sg6336/Clock_STM8/README.md

# Clock_STM8
Схема годинника зроблена в Altium. На перевірку

https://youtube.com/shorts/jYWQ8iIIEtU
