sg6336/Clock_STM8/Embedded STM8S103F3/STM8_Clock_Ajax/README.md

```
project-root/
│
├── config/
│
├── core/                       # Бізнес-логіка (платформонезалежна)
│   ├── logic/                  # Логіка годинника, зміни часу, інтерфейс користувача
│   └── interfaces/             # Інтерфейси, які реалізують драйвери
│
├── drivers/                    # Драйвери для периферії
│   ├── inc/                    # Відповідні заголовки для src/
│   │   ├── buttons/
│   │   ├── ds3231/
│   │   ├── tm1637/
│   │   └── uart/
│   │
│   └── src/                    # Платформозалежна реалізація (STM8, реєстри тощо)
│       ├── buttons/
│       ├── ds3231/
│       ├── tm1637/
│       └── uart/
│
├── platform/                   # Платформа і toolchain-специфічні файли
│   └── cosmic_stm8/
│       └── include/
│       │   └── iostm8s103.h    # Реєстри, визначені компілятором Cosmic
│       ├── scr/
│       └── inc/
│
├── startup/                    # Стартові файли (main.c, stm8_interrupt_vector.c)
│
├── tests/                      # Юніт-тести
│
├── build/                      # Збірка
│
├── tools/                      # Скріпти: .bat, генерація .lkf, прошивка
│
├── .vscode/                    # Налаштування для VS Code
│
└── README.md
```
Структура взаємодії:
```
[core/] (бізнес логіка)
     ⬇
[interfaces/] (контракт)
     ⬇
[drivers/] (реалізація інтерфейсу)
     ⬇
[hal/] (виклики до регістрів)
     ⬇
[iostm8s103.h] (реєстри STM8)
```
