sg6336/Clock_STM8/Docs/PCB_Clock_STM8.vProject_Version/Gerber_PCB_Clock_STM8.vProject_Version_(2025-02-28)/PCB_Requirements_PCB_Clock_STM8.v1.0.0.xlsx

PCB Name | PCB_Clock_STM8.v1.0 | Template version 1.0.3 | <Parameter PCB_Version not found>
Author | Denys
Amount boards per stand | 1
Produced within | 2 weeks
Item | Requirement | Comment
Layer count | 2
Size | 80 x 80 mm
Thickness | 1.6 mm
Material | FR-4
Min track/spacing | 0.254mm / 10mil
Min hole size | 0.6 mm
Copper weight | 1oz / 35um
Mask | on both sides
Mask color | Green / Yellow
Castellated holes edges | No
Surfaces finishing | HASL
Silkscreen | YES
Silkscreen color | White
Board Outline, Cutout | Mechanical1 (GM1)
Electric test | Necessarily for 100% samples
