sg6336/Clock_STM8/Embedded STM8S103F3/README.md

# Clock_STM8
Схема годинника зроблена в Altium. На перевірку

Clock_photo_rev.1
