sg6336/Clock_STM8/Docs/PCB_Clock_STM8.vProject_Version/Bill of Materials - PCB_Clock_STM8.vProject_Version.xlsx

Designator | Comment | Description | Footprint | LibRef | Quantity | Brand | Description(type) | Part Number | Replacement | Temperature of soldering | Tolerance | Country | Package | Datasheet
BT1 | CR2032 | Cell Holder for CR2032 | PCB_Battery | Battery | 1
C1 | 10uF | Cap Ceramic 10uF 25V B 10% Pad SMD 1206 85Â°C T/R | CAPC3216X190 | GRM31CB31E106KA75L | 1 |  |  |  |  |  |  |  | None
C2 | 22uF | CAPACITOR, 1206, X5R, 25V, 22UF; Dielectric Characteristic:X5R; Capacitance:22µF; Capacitance Tolerance:± 10%; Voltage Rating:25V; Series:GRM Hi-Cap; Capacitor Case Style:1206; No. of Pins:2; Capacitor Mounting:SMD; SVHC:No SVHC ;RoHS Compliant: Yes | CAPC3216X125N | GRM31CR61E226KE15L | 1 |  |  |  |  |  |  |  | None
C3, C4, C8, C12, C13 | 100nF | Ceramic capacitor SMD 1206 100 nF 50 V 10 % Samsung Electro-Mechanics CL31B104KBCNNNC 4000 pc(s) | CAPC3216X180N | CL31B104KBCNNNC | 5 |  |  |  |  |  |  |  | 1206 Samsung
C5, C9 | 1uF | CAP CER 1UF 25V X7R 1206 | CAPC3216X110N | C1206C105J3RACTU | 2 |  |  |  |  |  |  |  | None
C6, C7 | 100pF | CAP, MLCC, C0G, 100PF, 630V, 1206 | CAPC3216X110N | C1206C101JBGACTU | 2 |  |  |  |  |  |  |  | None
C10 | 100uF | 100µF Â±10% 6.3V Ceramic Capacitor X5R 1206 _3216 Metric_ | CAP3216X125N | GRM31CR60J107KE39L | 1 |  |  |  |  |  |  |  | 1206 Murata
C11 | 680nF | .68UF 50V 10% 1206 | CAPC3216X110N | C1206C684K5RACTU | 1 |  |  |  |  |  |  |  | None
D1 | 1N5819 | Diode Schottky 40 V 1A Surface Mount SOD-123 | SOD3715X145N | 1N5819HW-7 | 1 |  |  |  |  |  |  |  | SOD-123 Fairchild Semiconductor
D2 | LED | 2.6 V Red LED SMD | LEDC3216X120N | LHN974_RED_LED_1206 | 1 |  |  |  |  |  |  |  | None
D3 | LCD | Display, Seven Segment, 9.2MM, Red | LED_LDQ-M3604RI | LDQ-M3604RI | 1 |  |  |  |  |  |  |  | None
J1 | USB |  | GCT_USB4105-GF-A | USB4105-GF-A | 1 |  |  |  |  |  |  |  | None
R1, R2, R3, R4, R5, R6, R10, R11 | 10k | RES, 10K, 1%, 0.25W, 1206, THICK FILM; Resistor Case Style:1206 [3216 Metric]; Resistance:10kohm; Product Range:RC Series; Voltage Rating:200V; Resistor Element Material:Thick Film; Power Rating:250mW; Resistance Tolerance:Â± 1%; Temperature Coefficient:Â± 100ppm/Â°C; Automotive Qualification Standard:-; SVHC:No SVHC (15-Jan-2019) | RESC3216X71N | RC1206FR-0710KL | 8 |  |  |  |  |  |  |  | 1206-2 YAGEO
R7, R8, R9 | 1k | Surge Chip Resistor Automotive Grade Thick Film 1206 1kOhm 1% Paper T/R | RESC3116X65N | SR1206FR-071KL | 3 |  |  |  |  |  |  |  | 1206-2 YAGEO
SW1, SW2 | BUTTON | Alcoswitch, Switch, Tactile, 50 mA, SPST, Pushbutton, Off[On], FSM6JSMA | TE Connectivity FSM6JSMA | TE_4-1437565-9 | 4-1437565-9 | 2 |  |  |  |  |  |  |  | None
U1 | AMS1117-3.3 | LDO Voltage Regulators 1A, 3.3V | FP-AMS1117-IPC_A | CMP-209535-000001-1 | 1 |  |  |  |  |  |  |  | AMS1117
U2 | DS3231 | Extremely Accurate I2C-Integrated Real-Time Clock/TCXO/Crystal, 16-Pin SO, -40 to 85 degC, RoHS Qualified | W16#H2_N | CMP-0254-00293-2 | 1
U3 | TM1637 | LED Drive Control Special Circuit | SOIC127P1035X255-20N | TM1637_SOP20 | 1 |  |  |  |  |  |  |  | Package
U4 | STM8S103F3P6 | STM8 series Microcontroller IC 8-Bit 16MHz 8KB (8K x 8) FLASH 20-TSSOP | SOP65P640X120-20N | STM8S103F3P6 | 1 |  |  |  |  |  |  |  | TSSOP-20 STMicroelectronics
