sg6336/Clock_STM8/Altium/PCB_Clock_STM8/Docs/PCB_Clock_STM8_Fabrication.pdf

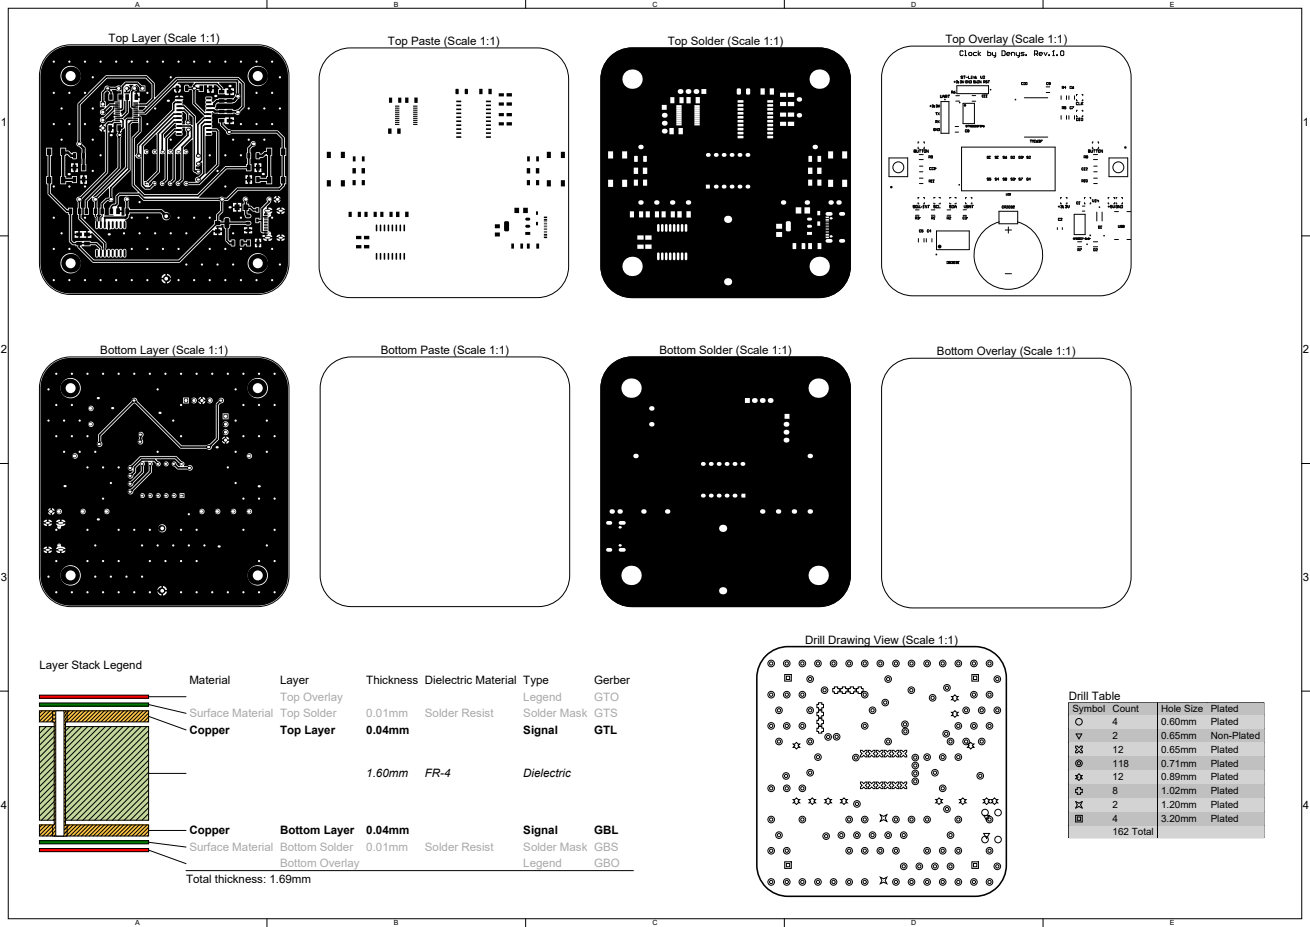
[picture p2: page 1]
Top Paste (Scale 1:1); Top Solder (Scale 1:1); Bottom Paste (Scale 1:1); Bottom Solder (Scale 1:1); Material; Layer; Thickness Dielectric Material Type; Gerber; Top Overlay; Legend; GTO; Surface Material Top Solder; Solder Resist; Solder Mask GTS; Copper; Top Layer; Signal; GTL; Dielectric; Bottom Layer 0.04mm; GBL; Surface Material Bottom Solder 0.01mm; Solder Mask GBS; Bottom Overlay; GBO; Total thickness: 1.69mm; Drill Table

Top Layer (Scale 1:1)

Top Overlay (Scale 1:1)

Bottom Layer (Scale 1:1)

Bottom Overlay (Scale 1:1)

Drill Drawing View (Scale 1:1)

Layer Stack Legend

Symbol | Count | Hole Size | Plated

4 | 0.60mm | Plated
2 | 0.65mm | Non-Plated
12 | 0.65mm | Plated
118 | 0.71mm | Plated
12 | 0.89mm | Plated
8 | 1.02mm | Plated
2 | 1.20mm | Plated
4 | 3.20mm | Plated
162 Total
