sg6336/Clock_STM8/Docs/PCB_Clock_STM8.vProject_Version/Internal_PCB_Clock_STM8.vProject_Version.PDF

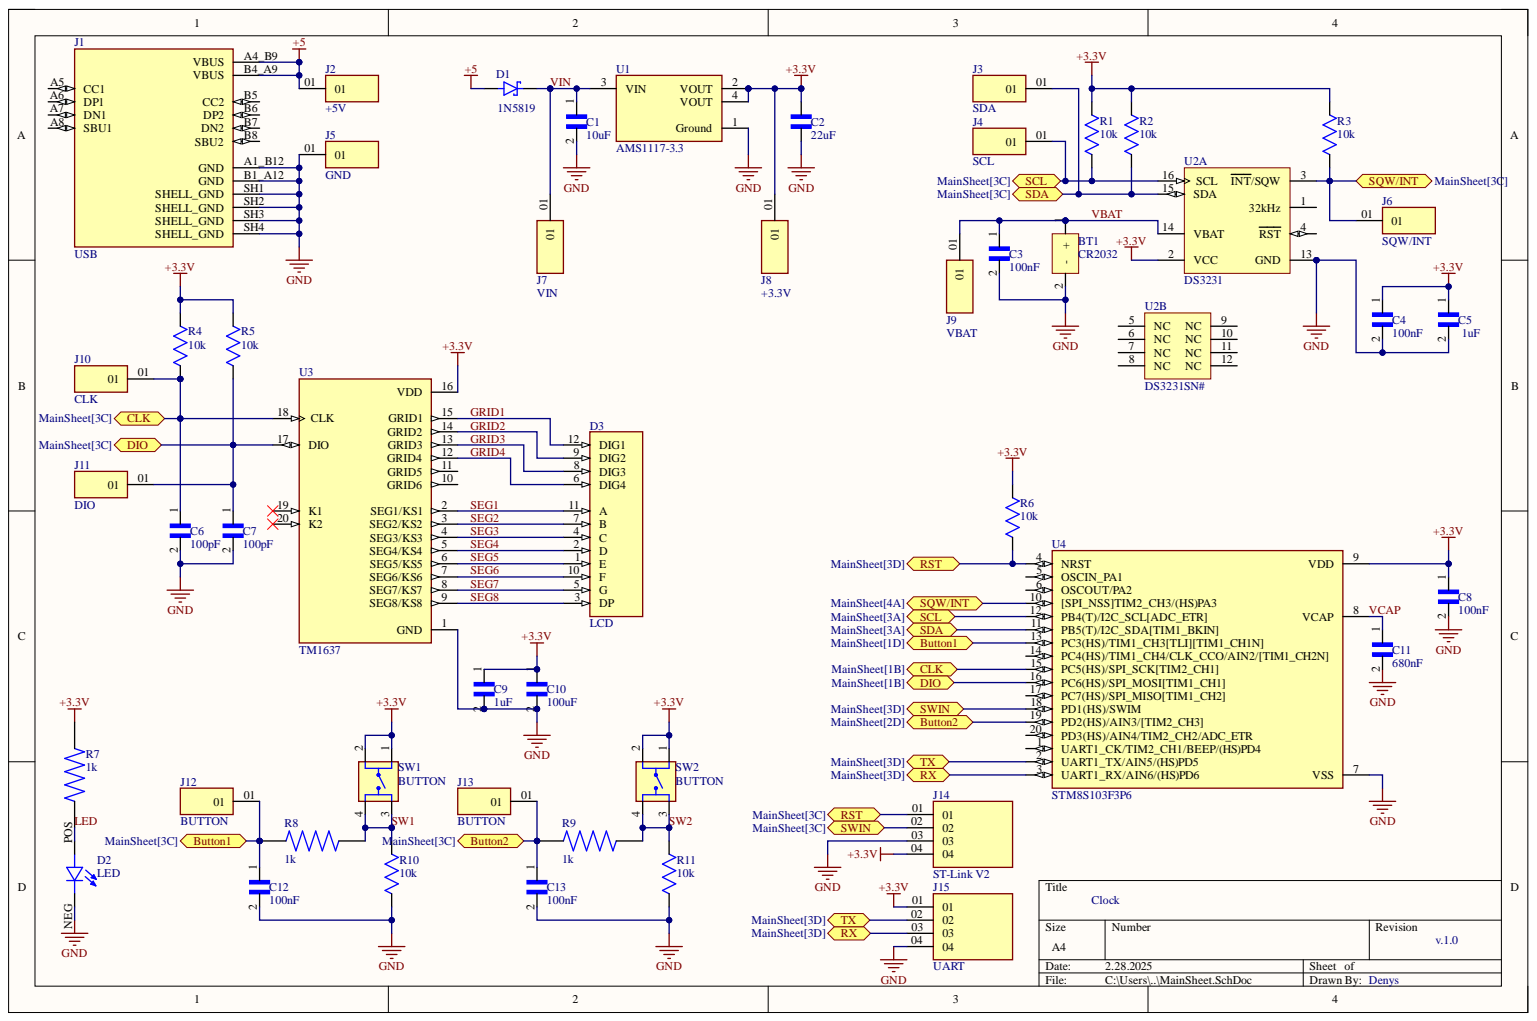
[picture p3: page 1]

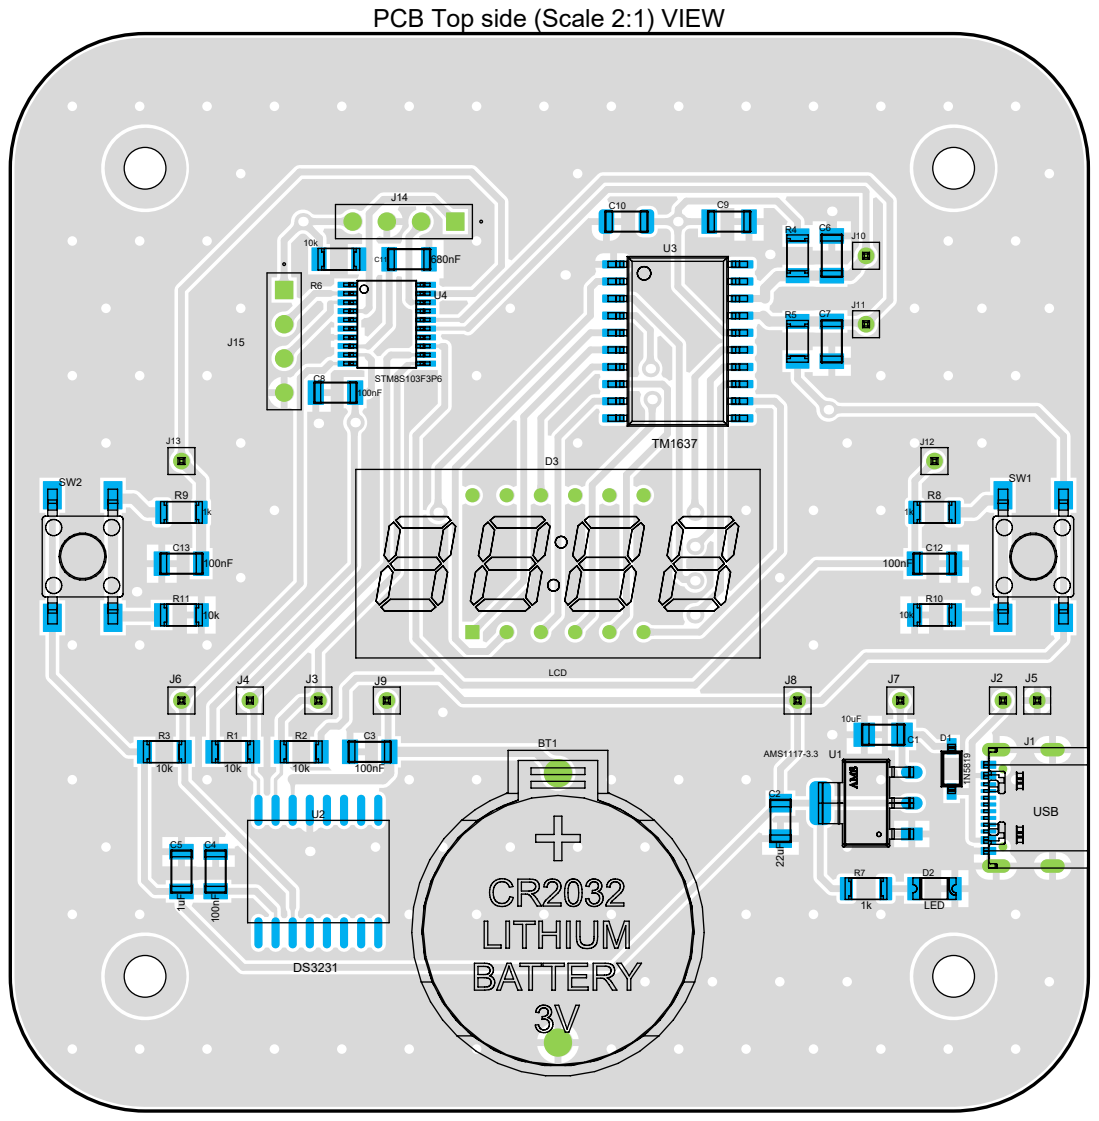
[picture p4: page 2]

PCB Top side (Scale 2:1) VIEW

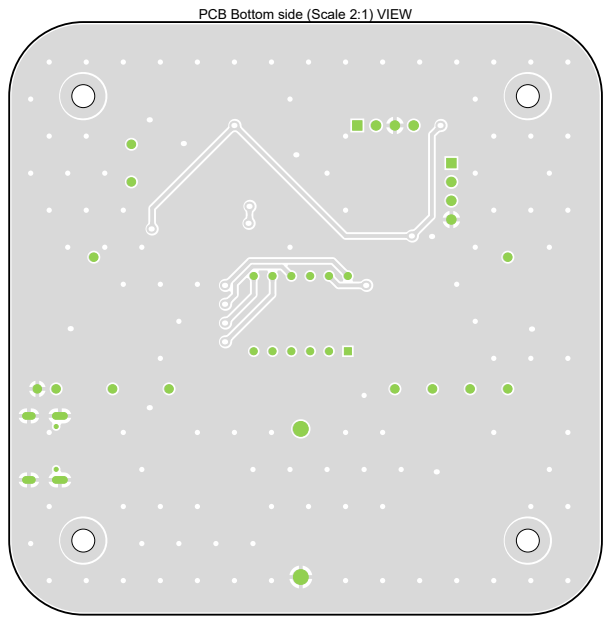
[picture p5: page 3]

PCB Bottom side (Scale 2:1) VIEW

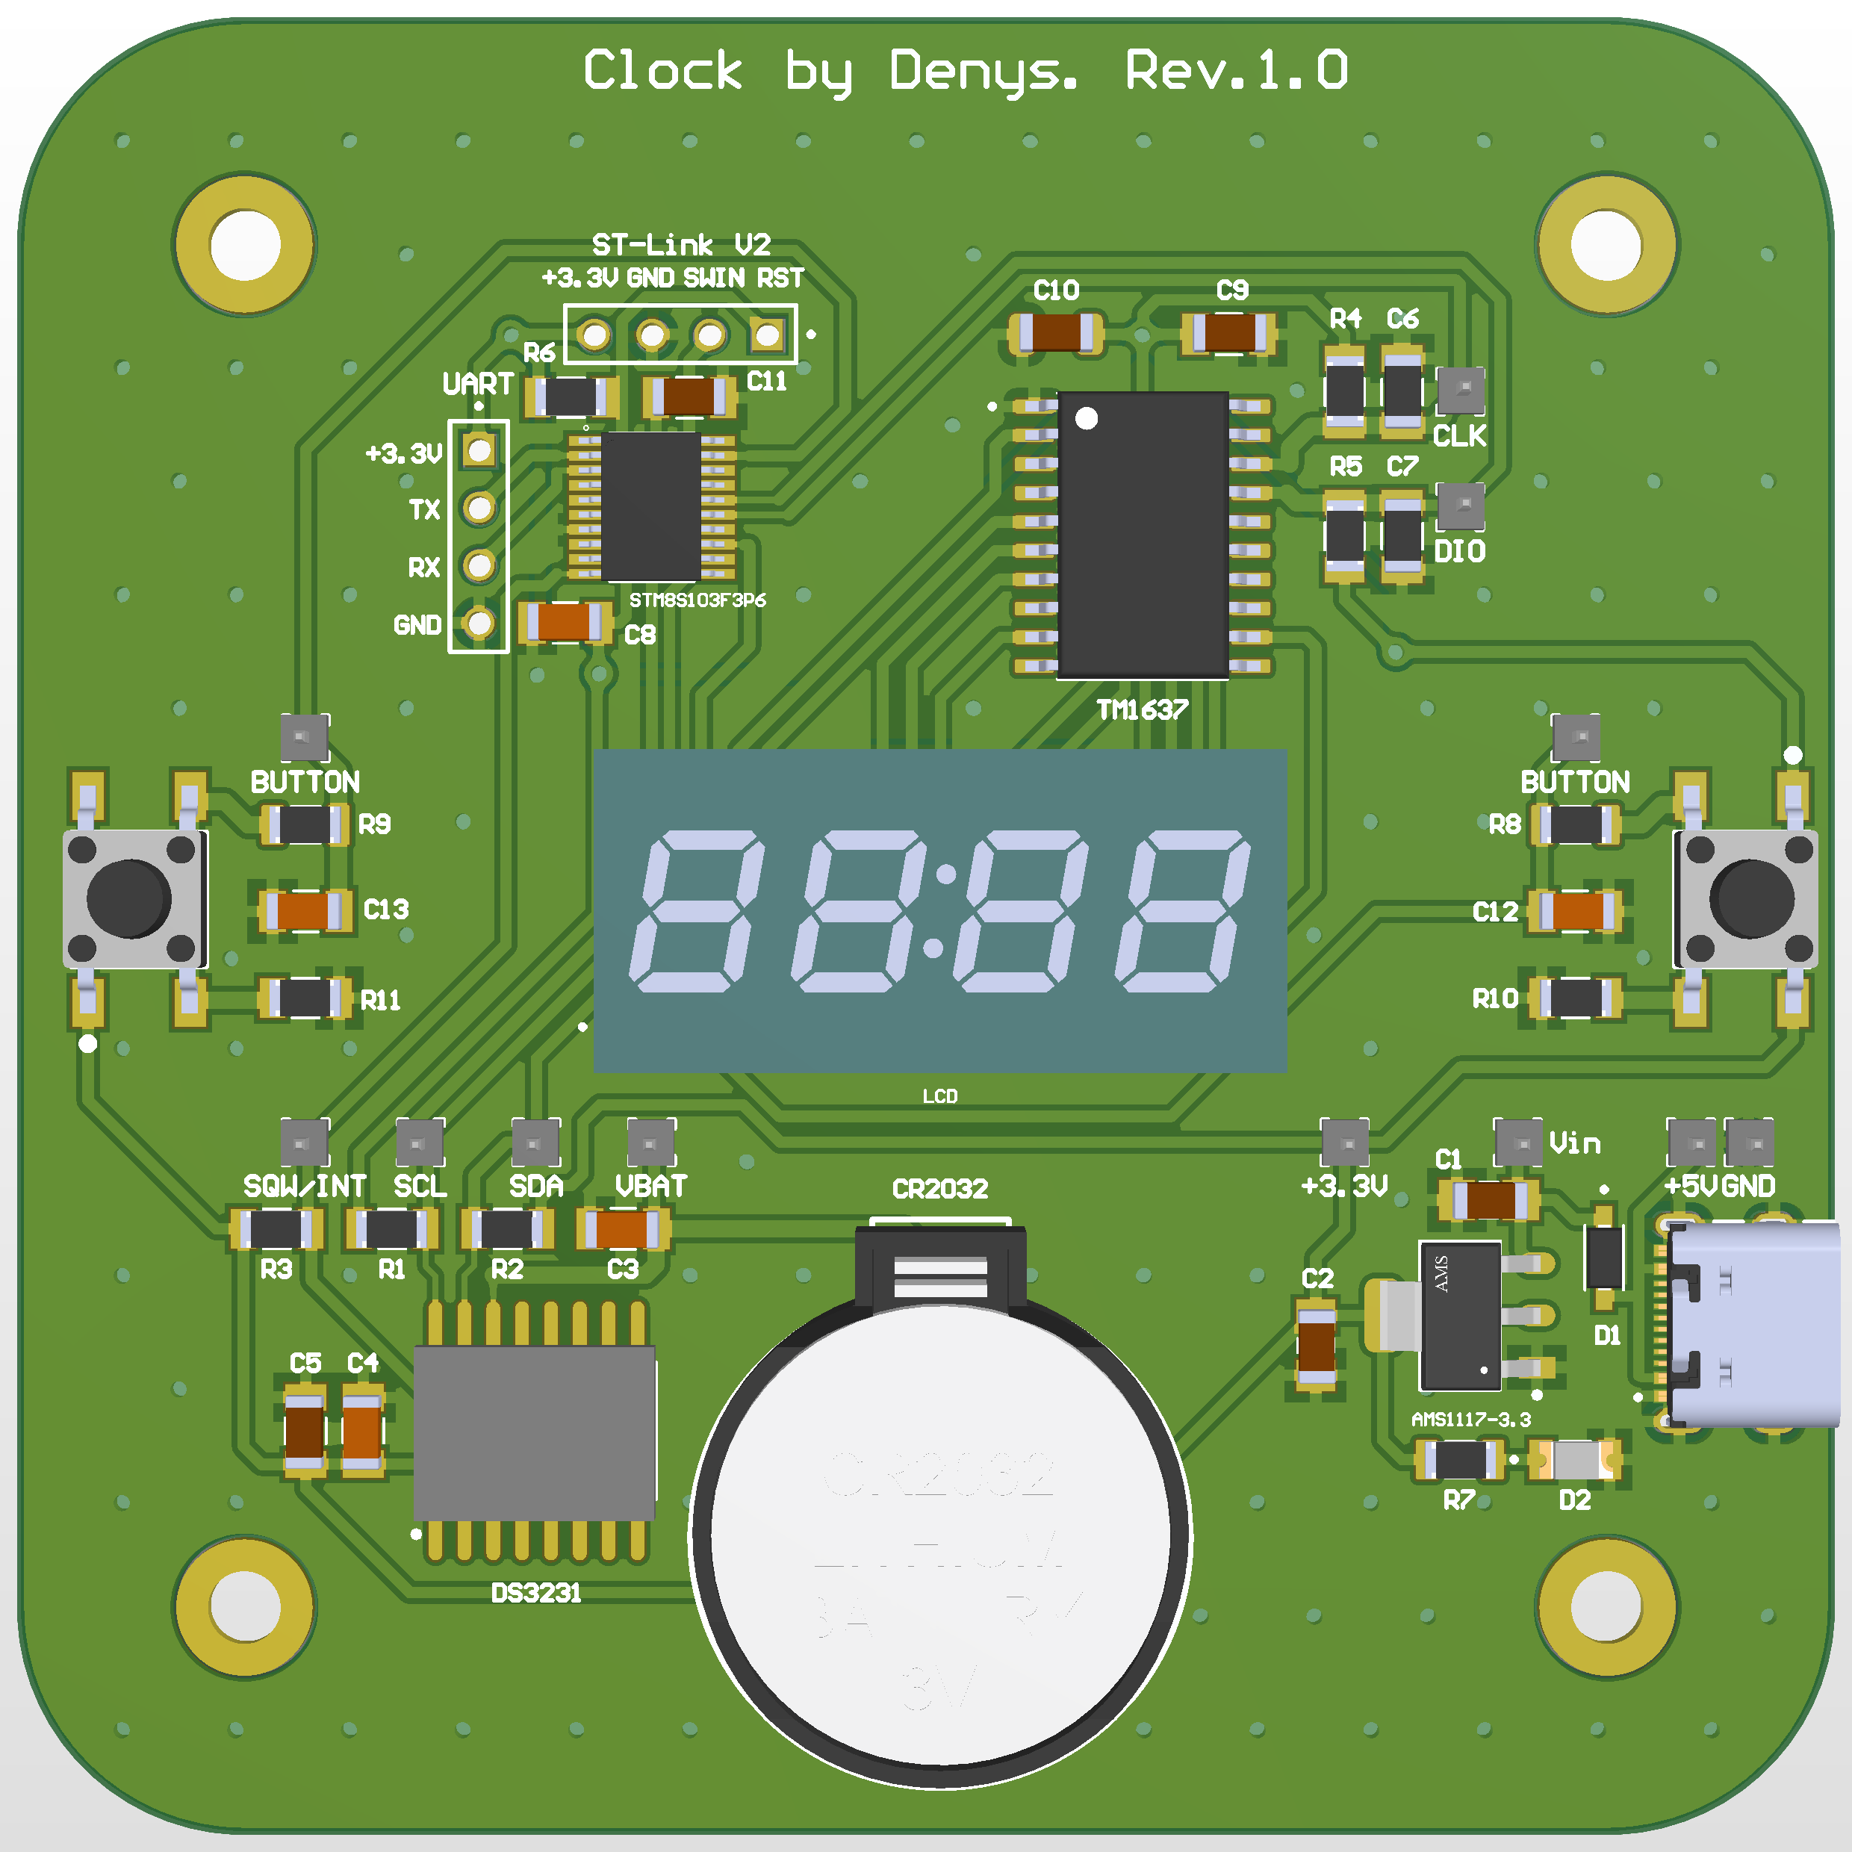
[picture p6: page 4]

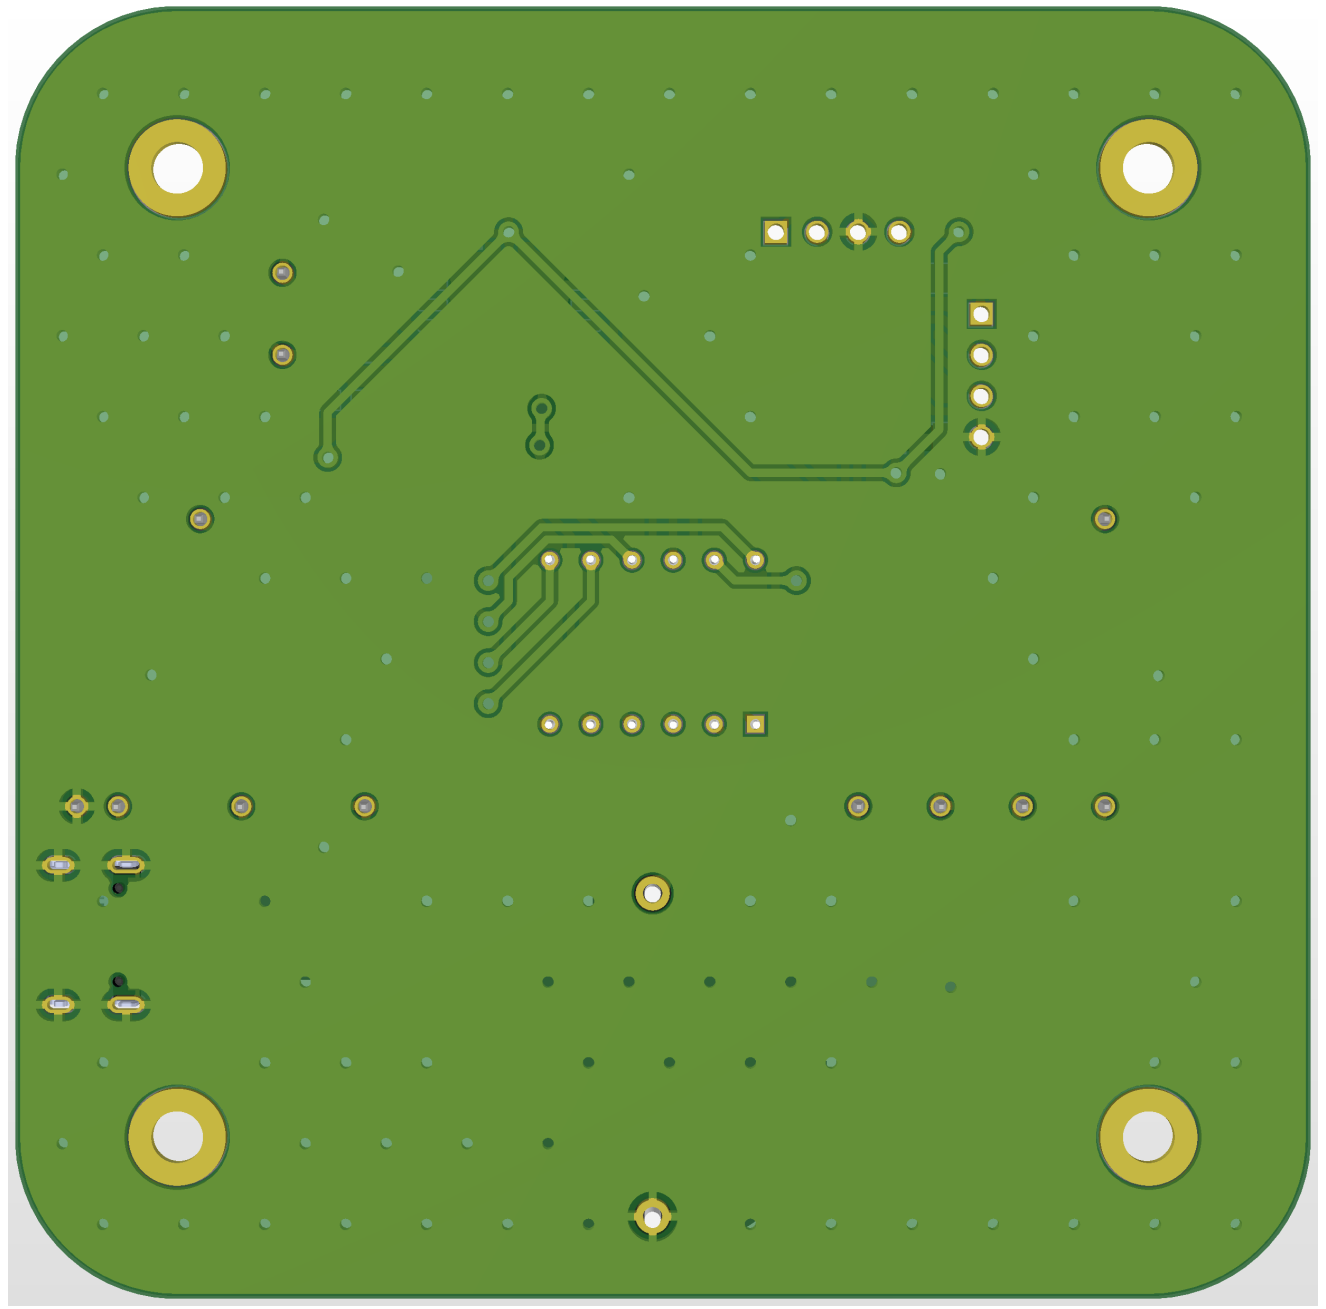
[picture p7: page 5]

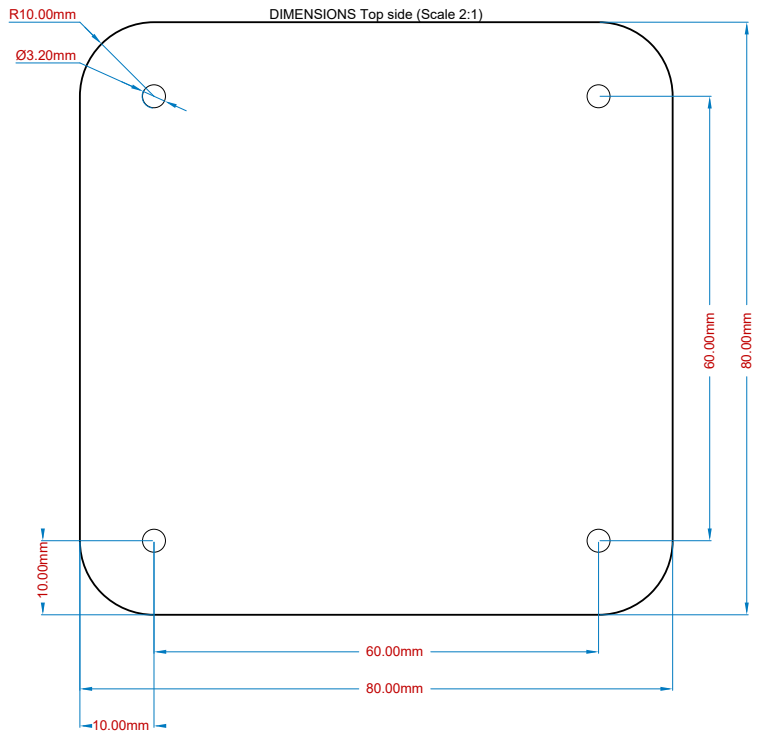
[picture p8: page 6]

DIMENSIONS Top side (Scale 2:1)
