sg6336/Clock_STM8/Altium/PCB_Clock_STM8/v.Project_version.PDF

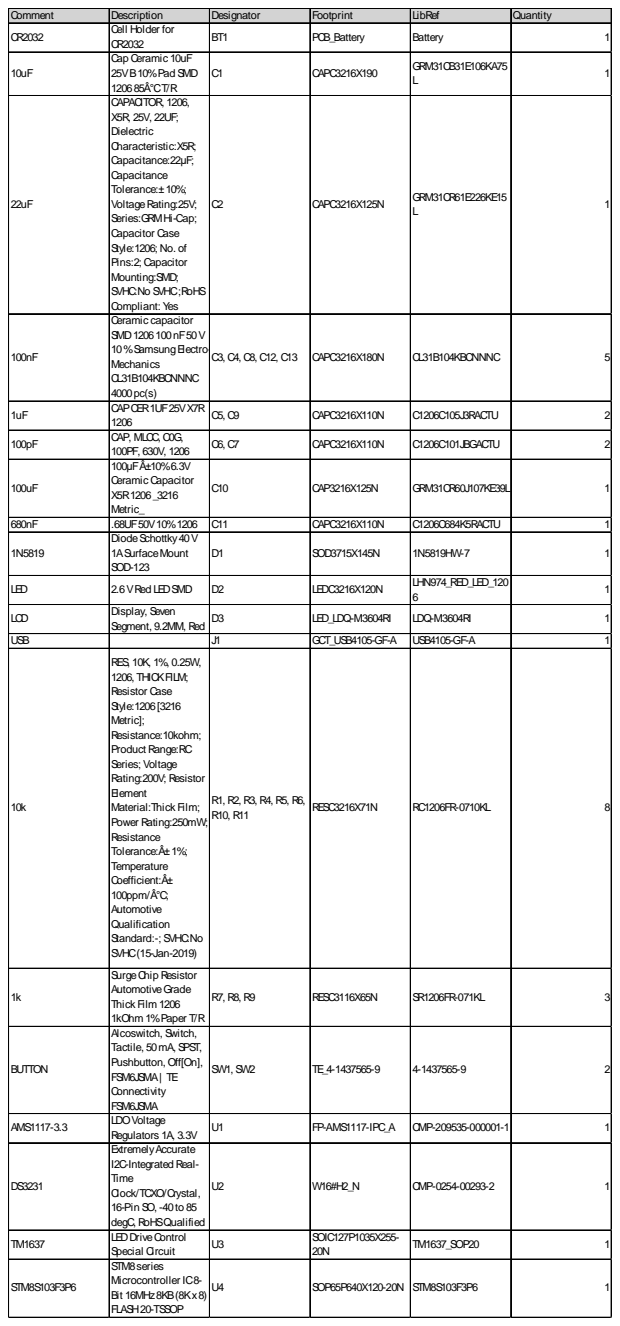
[picture p9: page 1]

Comment | Description | Designator | Footprint | LibRef | Quantity
CR2032 | Cell Holder for CR2032 | BT1 | PCB_Battery | Battery | 1

10uF | Cap Ceramic 10uF 25VB10%Pad SMD 120685Â°CT/R | C1 | CAPC3216X190 | GRM31CB31E106KA75 L | 1

22uF | CAPACITOR, 1206, X5R, 25V, 22UF; Dielectric Characteristic:X5R; Capacitance:22µF; Capacitance Tolerance:±10%; VoltageRating:25V; Series:GRMHi-Cap; Capacitor Case Style:1206; No. of Pins:2; Capacitor Mounting:SMD; SVHC:No SVHC;RoHS Compliant: Yes | C2 | CAPC3216X125N | GRM31CR61E226KE15 L | 1

100nF | Ceramic capacitor SMD1206100nF50V 10%SamsungElectro-Mechanics CL31B104KBCNNNC 4000pc(s) | C3, C4, C8, C12, C13 | CAPC3216X180N | CL31B104KBCNNNC | 5

1uF | CAPCER1UF25VX7R 1206 | C5, C9 | CAPC3216X110N | C1206C105J3RACTU | 2

100pF | CAP, MLCC, C0G, 100PF, 630V, 1206 | C6, C7 | CAPC3216X110N | C1206C101JBGACTU | 2

100uF | 100µFÂ±10%6.3V Ceramic Capacitor X5R1206_3216 Metric_ | C10 | CAP3216X125N | GRM31CR60J107KE39L | 1

680nF | .68UF50V10%1206 | C11 | CAPC3216X110N | C1206C684K5RACTU | 1
1N5819 | DiodeSchottky40V 1ASurfaceMount SOD-123 | D1 | SOD3715X145N | 1N5819HW-7 | 1

LED | 2.6VRed LEDSMD | D2 | LEDC3216X120N | LHN974_RED_LED_120 6 | 1

LCD | Display, Seven Segment, 9.2MM, Red | D3 | LED_LDQ-M3604RI | LDQ-M3604RI | 1

USB | | J1 | GCT_USB4105-GF-A | USB4105-GF-A | 1

10k | RES, 10K, 1%, 0.25W, 1206, THICKFILM; Resistor Case Style:1206[3216 Metric]; Resistance:10kohm; Product Range:RC Series; Voltage Rating:200V; Resistor Element Material:Thick Film; Power Rating:250mW; Resistance Tolerance:Â±1%; Temperature Coefficient:Â± 100ppm/Â°C; Automotive Qualification Standard:-; SVHC:No SVHC(15-Jan-2019) | R1, R2, R3, R4, R5, R6, R10, R11 | RESC3216X71N | RC1206FR-0710KL | 8

1k | SurgeChip Resistor AutomotiveGrade Thick Film 1206 1kOhm 1%Paper T/R | R7, R8, R9 | RESC3116X65N | SR1206FR-071KL | 3

BUTTON | Alcoswitch, Switch, Tactile, 50mA, SPST, Pushbutton, Off[On], FSM6JSMA| TE Connectivity FSM6JSMA | SW1, SW2 | TE_4-1437565-9 | 4-1437565-9 | 2

AMS1117-3.3 | LDOVoltage Regulators 1A, 3.3V | U1 | FP-AMS1117-IPC_A | CMP-209535-000001-1 | 1

DS3231 | ExtremelyAccurate I2C-Integrated Real-Time Clock/TCXO/Crystal, 16-Pin SO, -40to 85 degC, RoHSQualified | U2 | W16#H2_N | CMP-0254-00293-2 | 1

TM1637 | LEDDriveControl Special Circuit | U3 | SOIC127P1035X255-20N | TM1637_SOP20 | 1

STM8S103F3P6 | STM8series Microcontroller IC8-Bit 16MHz8KB(8Kx8) FLASH20-TSSOP | U4 | SOP65P640X120-20N | STM8S103F3P6 | 1
