sg6336/Clock_STM8/Altium/PCB_Clock_STM8/Docs/PCB_Clock_STM8_Assembly.pdf

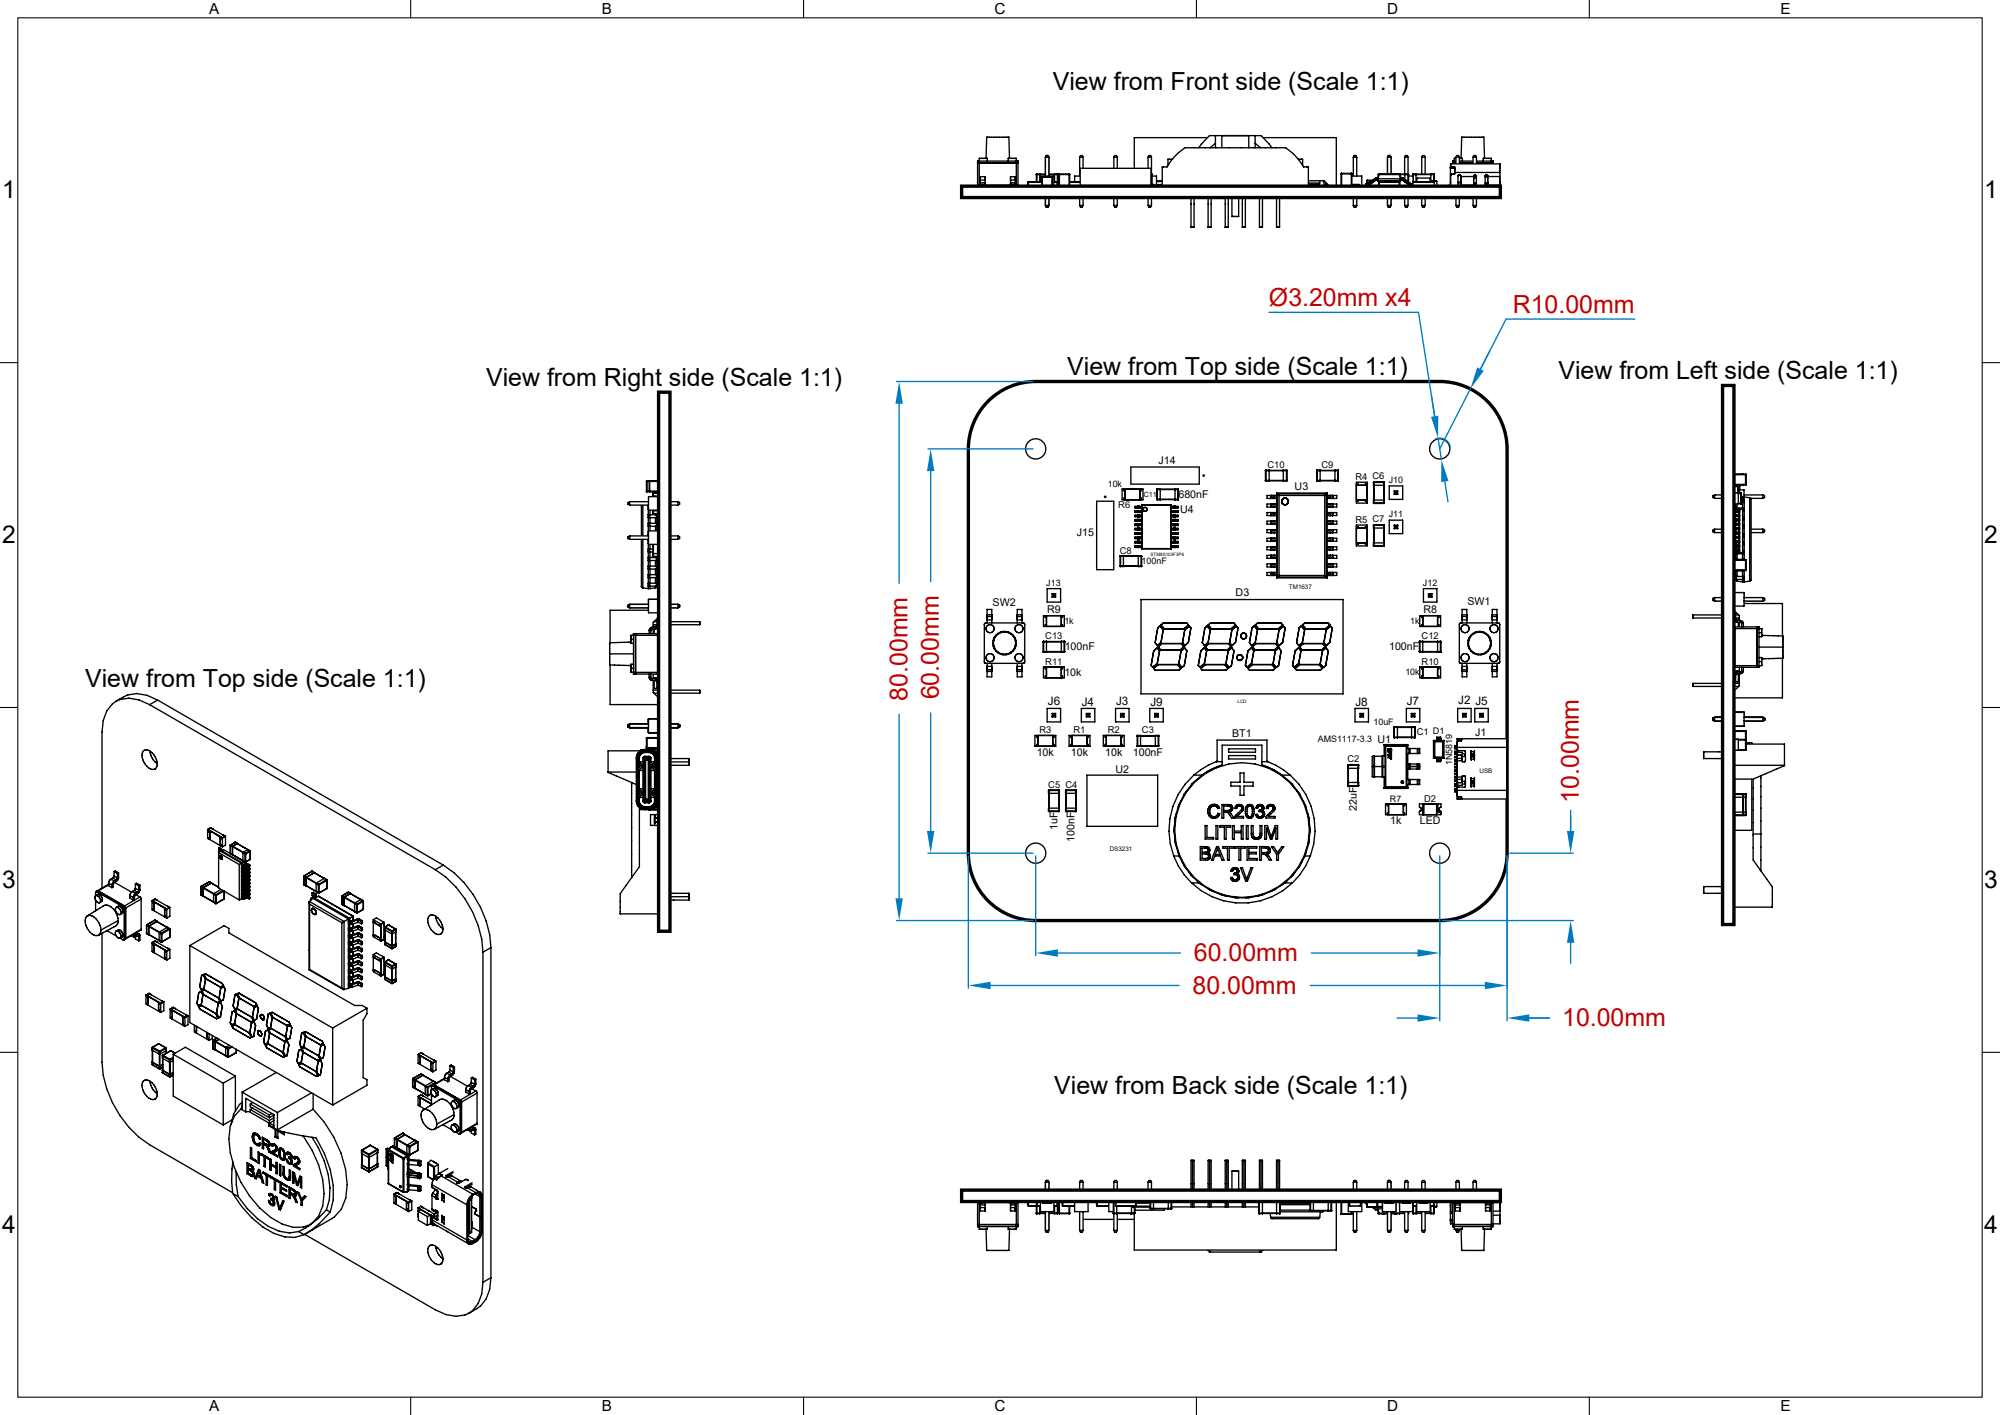
[picture p10: page 1]

View from Front side (Scale 1:1)

View from Top side (Scale 1:1)

View from Back side (Scale 1:1)
