sg6336/Clock_STM8/Altium/PCB_Clock_STM8/PCB_Clock_STM8.pdf

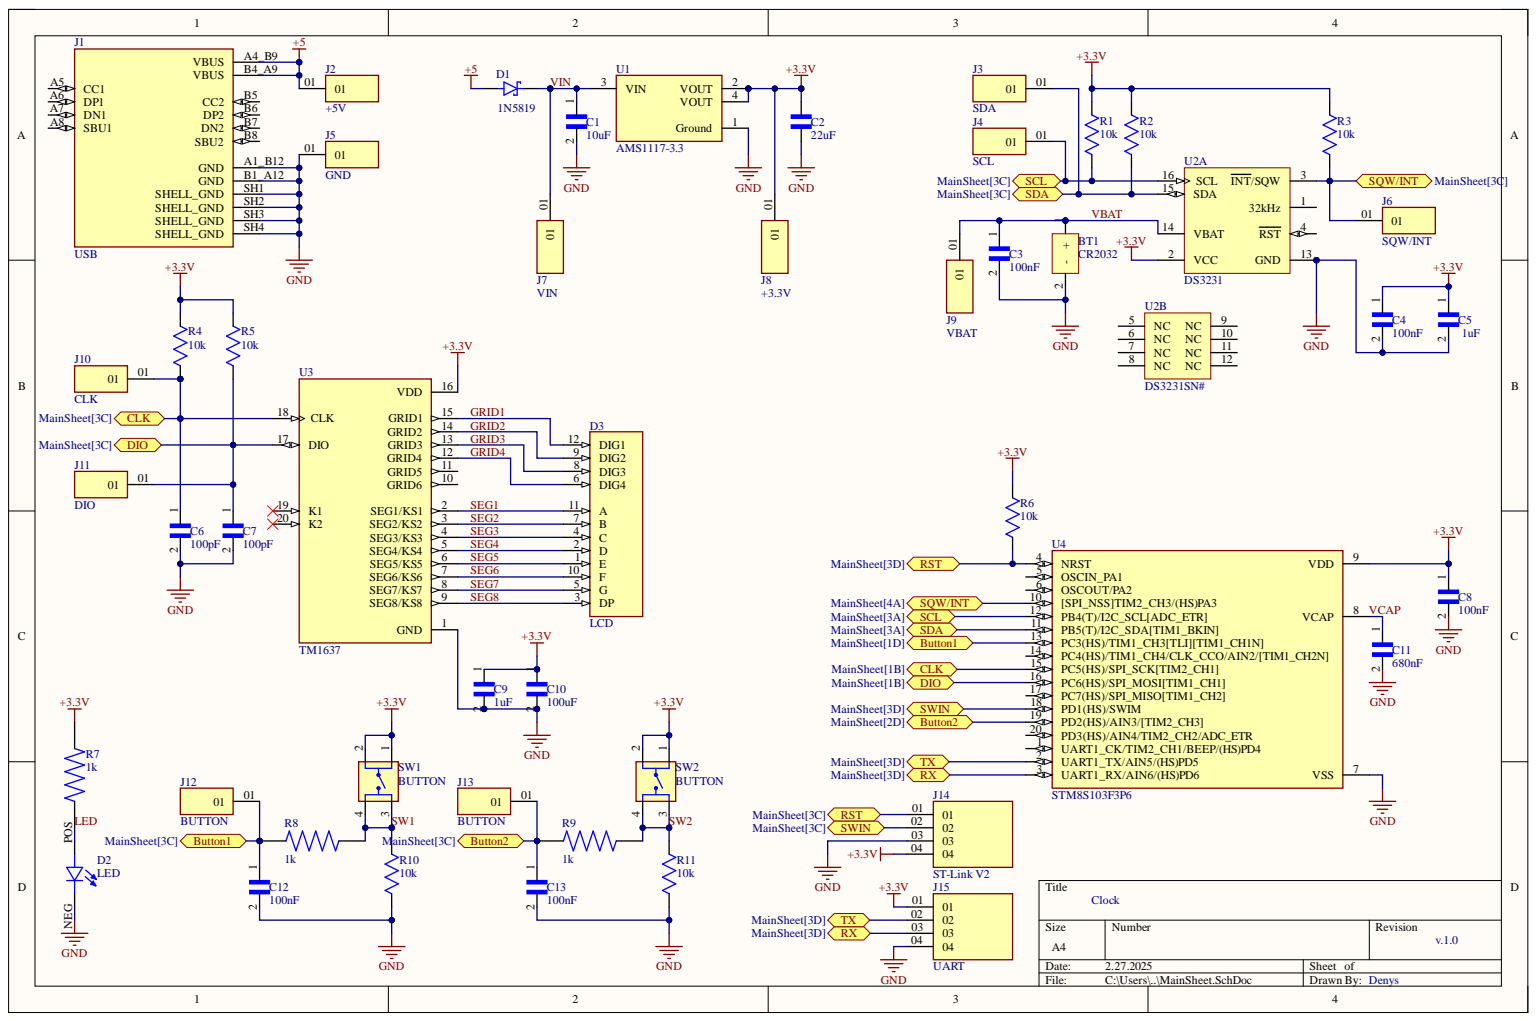
[picture p11: page 1]

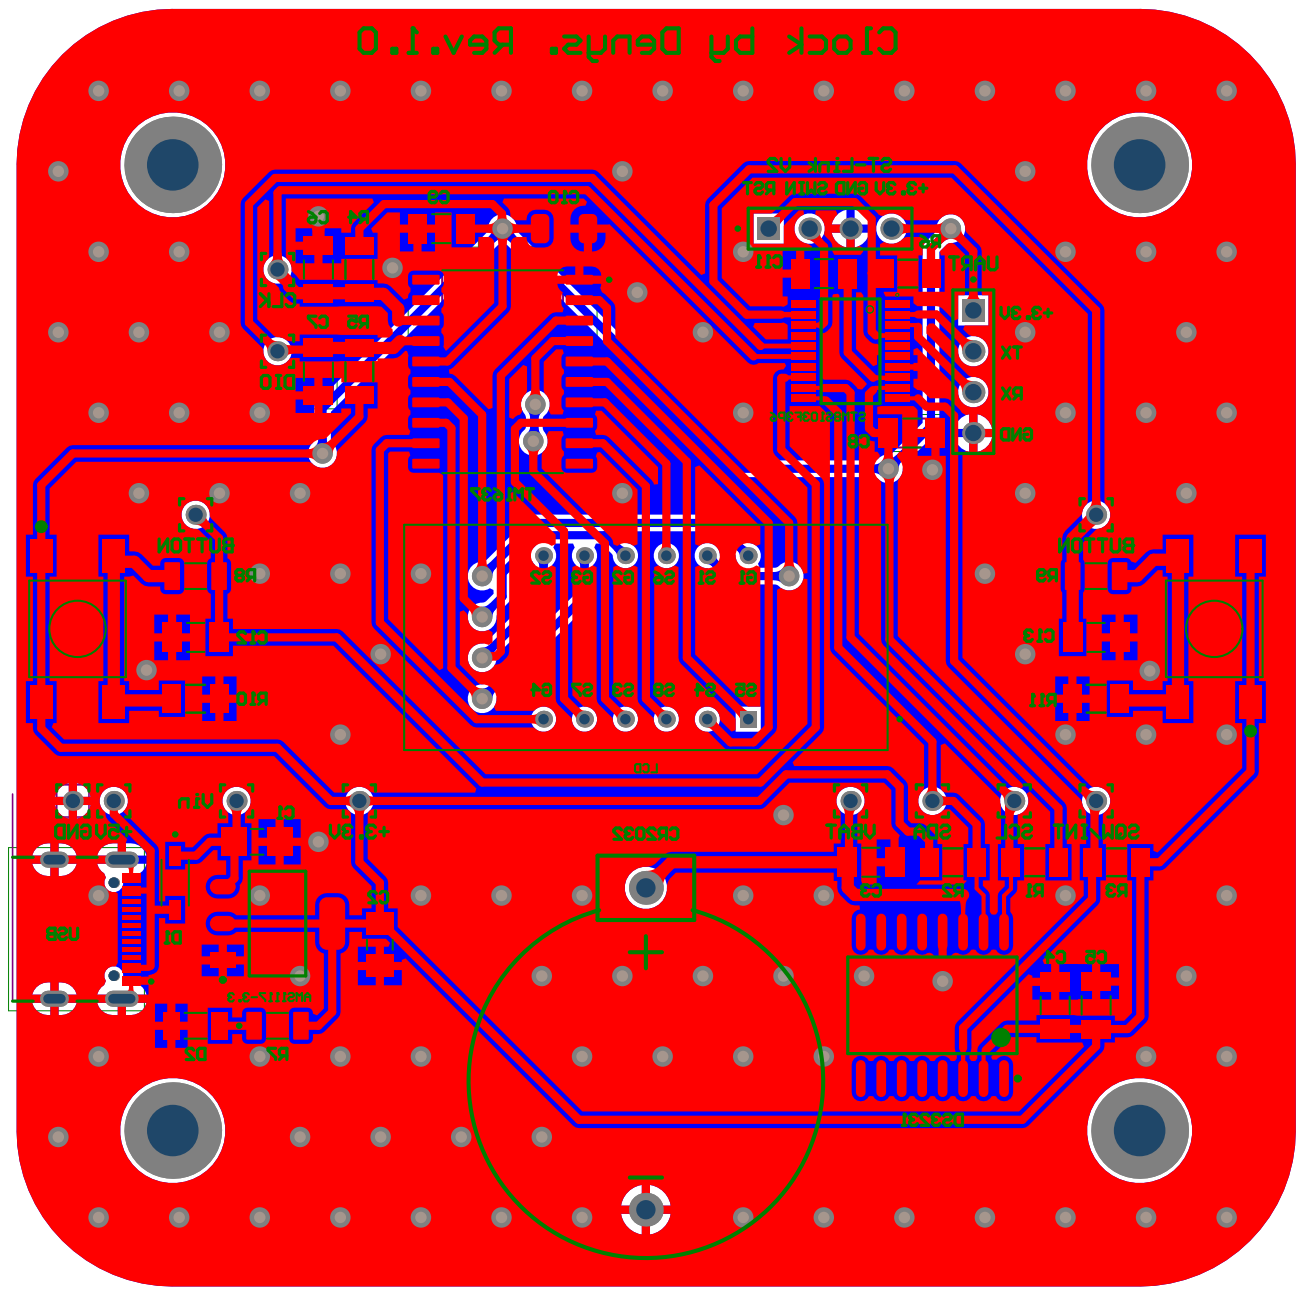
[picture p12: page 2]
