sg6336/Clock_STM8/(list of files, drawings)

Other design files:
Altium/PCB_Clock_STM8/MainSheet.SchDoc
Altium/PCB_Clock_STM8/PCB_Clock_STM8.PcbDoc
Altium/PCB_Clock_STM8/PCB_Clock_STM8.PrjPcb
Altium/PCB_Clock_STM8/PCB_Clock_STM81/PCB_Clock_STM8.PcbLib
Altium/PCB_Clock_STM8/PCB_Clock_STM81/PCB_Clock_STM8_1.SCHLIB
