sg6336/Clock_STM8/Embedded STM8S103F3/STM8_Clock_Ajax/platform/cosmic_stm8/scr/delay.c

// =============================================================================
//     Includes
// =============================================================================
#include <stdint.h>

// ============================================================================
//     Public API functions
// ============================================================================
void delay_ms(uint16_t ms)
{
    volatile uint16_t i;

    while (ms--)
    {
        for (i = 0; i < 1600; i++)
        {
            __asm("nop");
        }
    }
}
