sg6336/Clock_STM8/Embedded STM8S103F3/STM8_Clock_Ajax/platform/cosmic_stm8/scr/exti_watchdog.c

// =============================================================================
//     Includes
// =============================================================================
#include "exti_watchdog.h"
#include "button.h"

// ============================================================================
//     Public API functions
// ============================================================================
void exti_watchdog_poll()
{
    // Watchdog-style recovery for EXTI — re-enables interrupts if stuck
    Button_Hour_EnsureInterruptEnabled();
    Button_Minute_EnsureInterruptEnabled();
}
