sg6336/Clock_STM8/(commit log)

2025-01-29 Add MainSheet rev.1
    [MainSheet.SchDoc, PCB_Clock_STM8.PrjPcb]
2025-01-29 Add MainSheet rev.1.1
    [MainSheet.SchDoc, PCB_Clock_STM8.PrjPcb]
2025-02-11 Add PCB
    [MainSheet.SchDoc, PCB_Clock_STM8.PcbDoc]
2025-02-23 Доробка плати
    [PCB_Clock_STM8.PcbDoc]
2025-02-23 Modified PCB
    [MainSheet.SchDoc, PCB_Clock_STM8.PcbDoc]
2025-02-24 Modified PCB and BOM
    [MainSheet.SchDoc, PCB_Clock_STM8.PcbDoc]
2025-02-27 Modified Draftsman
    [PCB_Clock_STM8.PrjPcb]
2025-02-27 in prgress. Files for Manufacturer
    [Bill of Materials-PCB_Clock_STM8.xls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]
2025-02-27 Add Ajax_Auto_OutJob_template.OutJob
    [PCB_Clock_STM8.PrjPcb]
2025-02-27 Add folders Docs and Mech to root
    [BOM -PCB_Clock_STM8.vProject_Version (Cables).xlsx, BOM -PCB_Clock_STM8.vProject_Version (Finished parts).xlsx, Bill of Materials - PCB_Clock_STM8.vProject_Version.xlsx, PCB_Clock_STM8.vProject_Version (Cable list).xlsx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]
2025-02-27 Deleted my out folder
    [Bill of Materials-PCB_Clock_STM8.xls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]
2025-02-27 Add Docs
    [BOM -PCB_Clock_STM8.vProject_Version (Cables).xlsx, BOM -PCB_Clock_STM8.vProject_Version (Finished parts).xlsx, Bill of Materials - PCB_Clock_STM8.vProject_Version.xlsx, PCB_Clock_STM8.vProject_Version (Cable list).xlsx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]
2025-02-27 Add PCB_Requirements_.xlsx
    [PCB_Clock_STM8.PcbDoc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]
2025-02-28 Modified Internal_PCB
    [PCB_Clock_STM8.PrjPcb, PCB_Requirements_PCB_Clock_STM8.v1.0.0.xlsx]
