sg6336/Clock_STM8/Embedded STM8S103F3/Clock_photo_rev.1.jpg

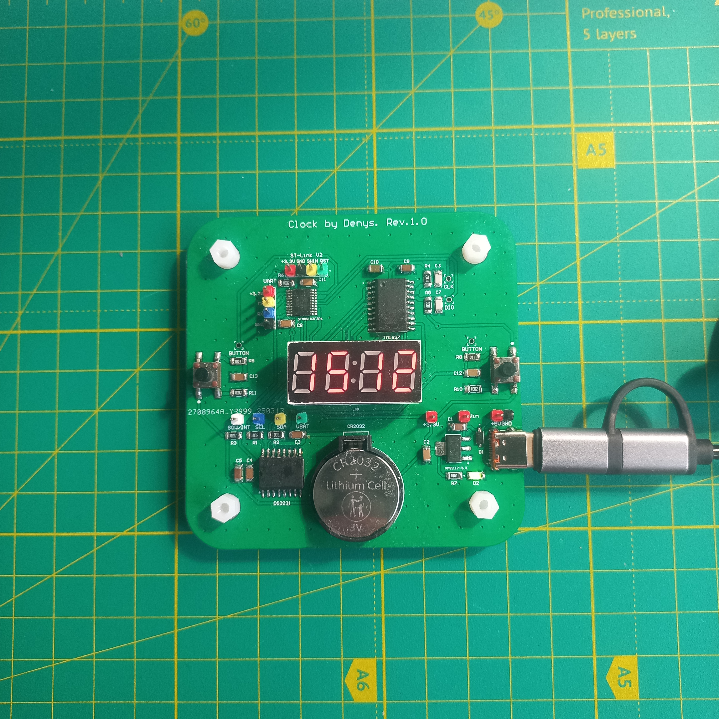
[picture p1: Embedded STM8S103F3/Clock_photo_rev.1.jpg]
Embedded STM8S103F3/Clock_photo_rev.1.jpg
